quill0224/aoc-final-group13/pics/APR_redSRAM_blueIOPad.PNG

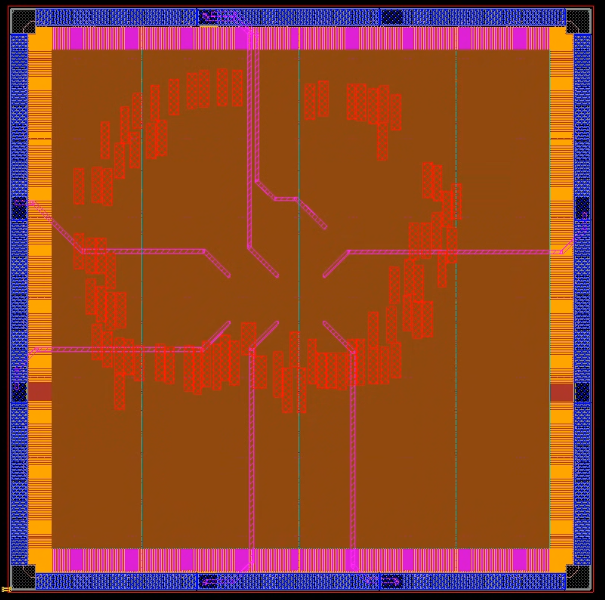
pics/APR_redSRAM_blueIOPad.PNG
