quill0224/aoc-final-group13/pics/APR_delete mark.PNG

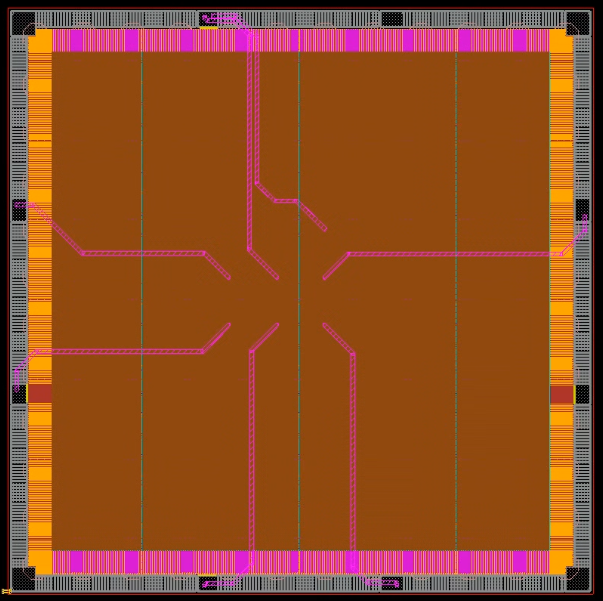
pics/APR_delete mark.PNG
