quill0224/aoc-final-group13/pics/APR.PNG

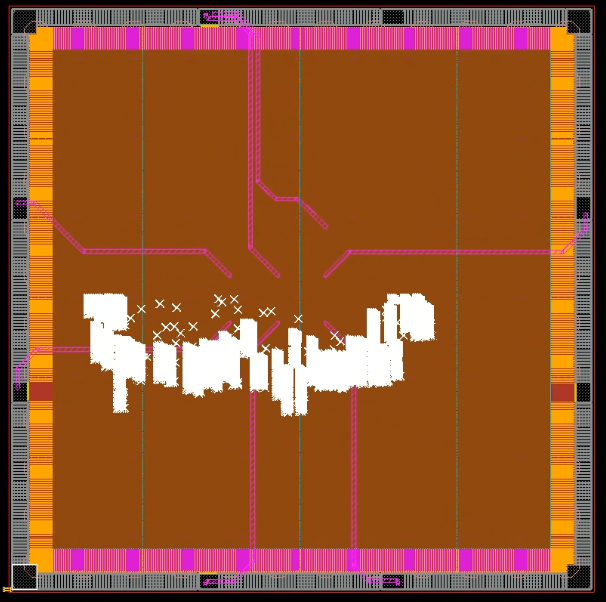
pics/APR.PNG
