quill0224/aoc-final-group13/pics/APR_redSRAM_blueIOPad_yellowclk.PNG

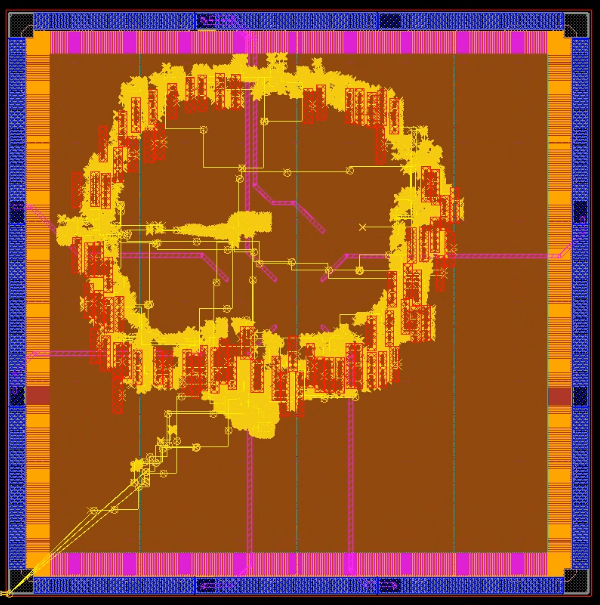
pics/APR_redSRAM_blueIOPad_yellowclk.PNG
