quill0224/aoc-final-group13/pics/clktree.PNG

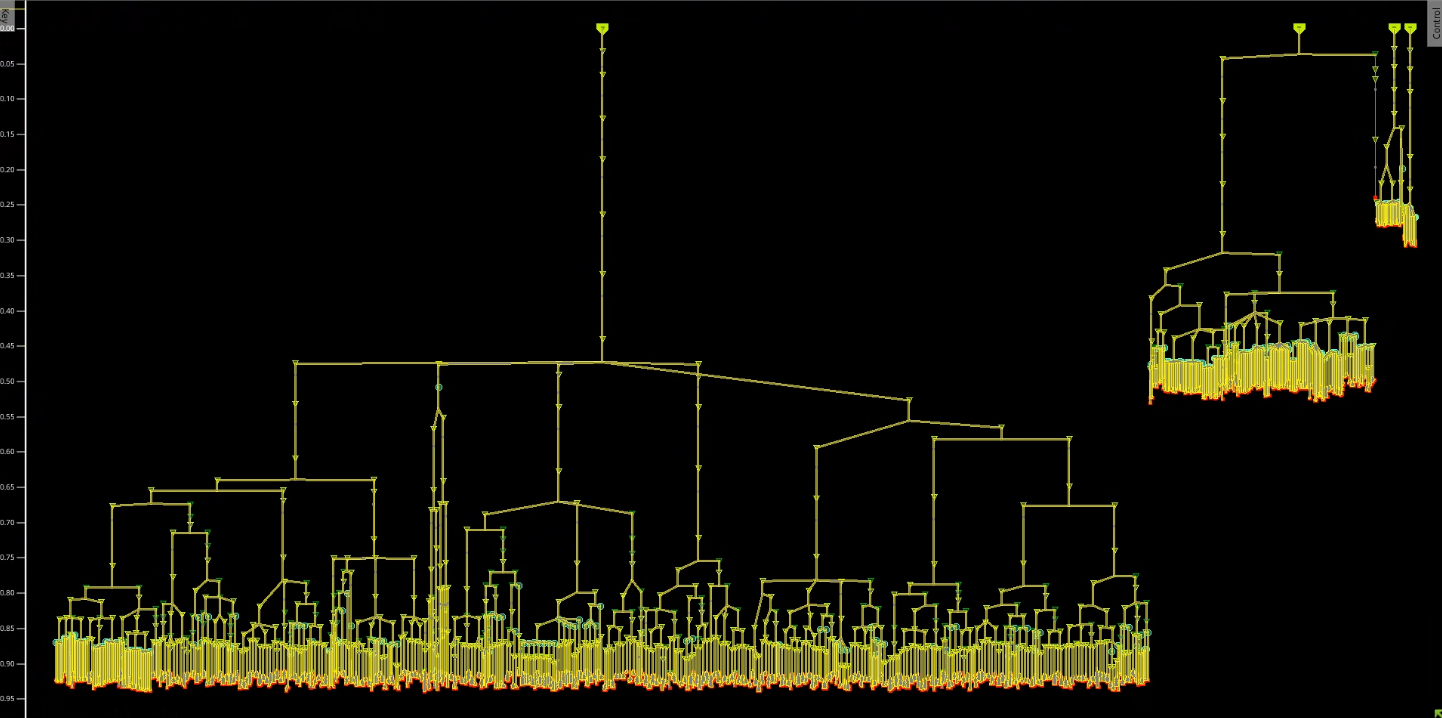
pics/clktree.PNG
