quill0224/aoc-final-group13/pics/soc_architecture.png

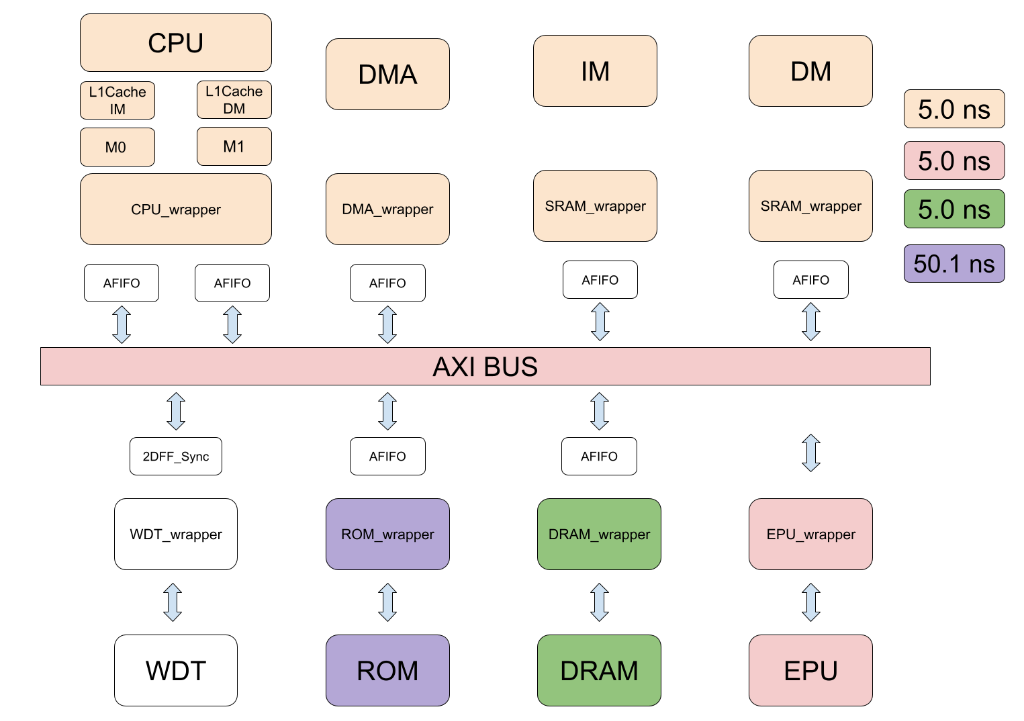
pics/soc_architecture.png
