quill0224/aoc-final-group13/pics/syn0_pass.png

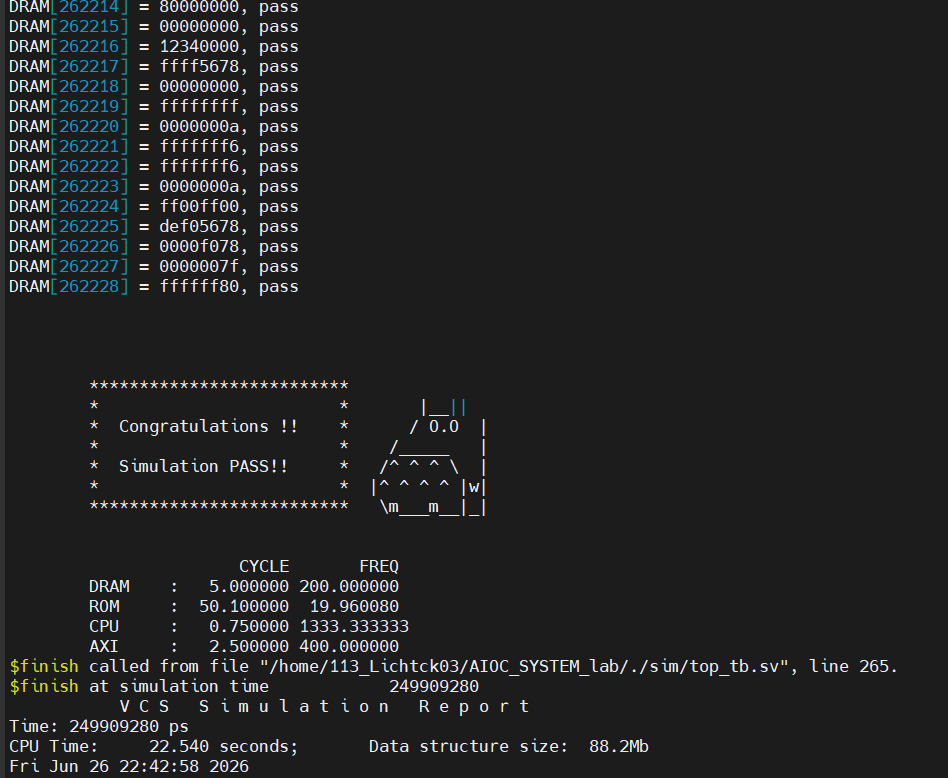
pics/syn0_pass.png
