quill0224/aoc-final-group13/pics/syn2_pass.png

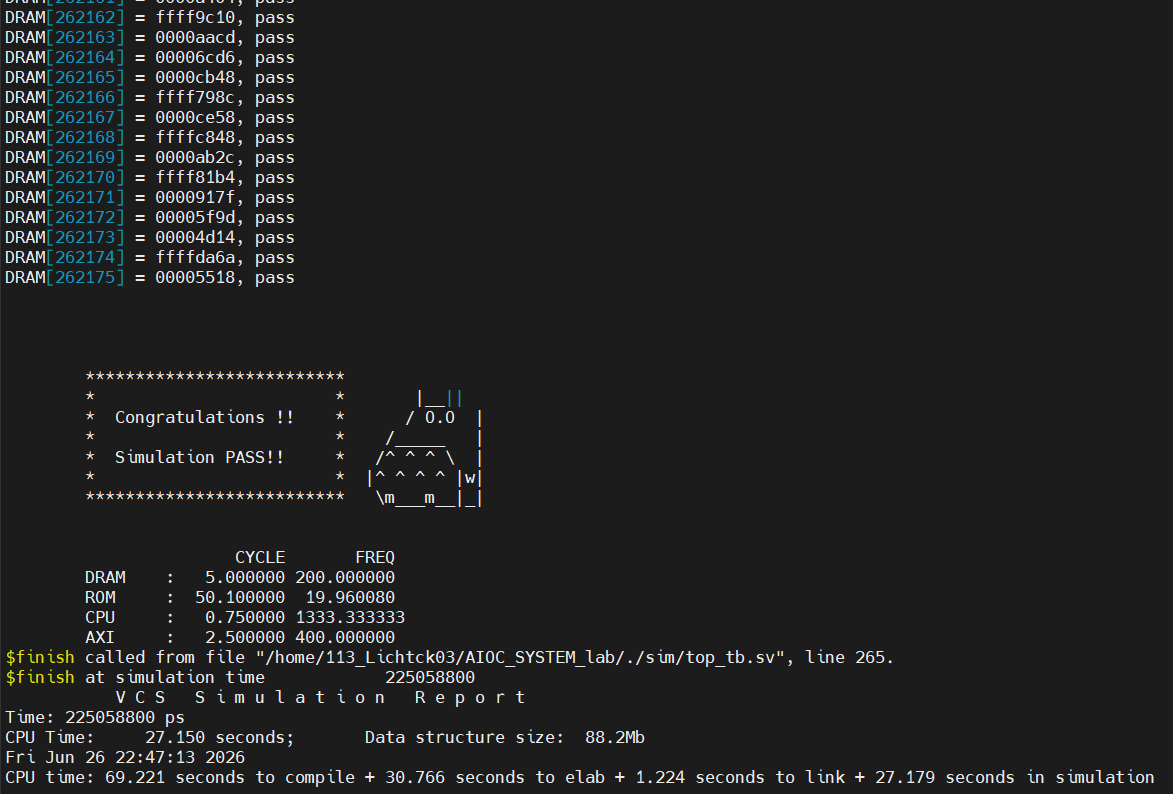
pics/syn2_pass.png
