quill0224/aoc-final-group13/pics/syn3_pass.png

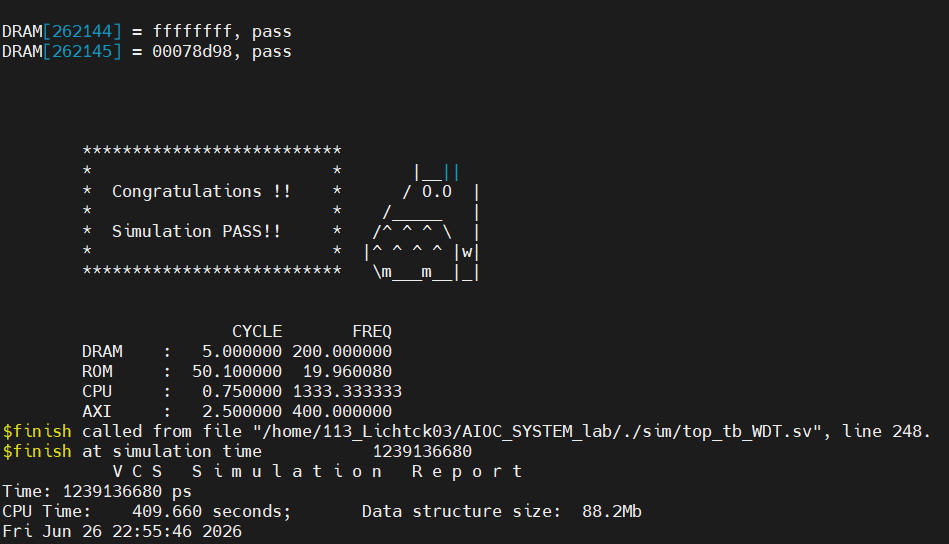
pics/syn3_pass.png
