quill0224/aoc-final-group13/pics/syn4_pass.png

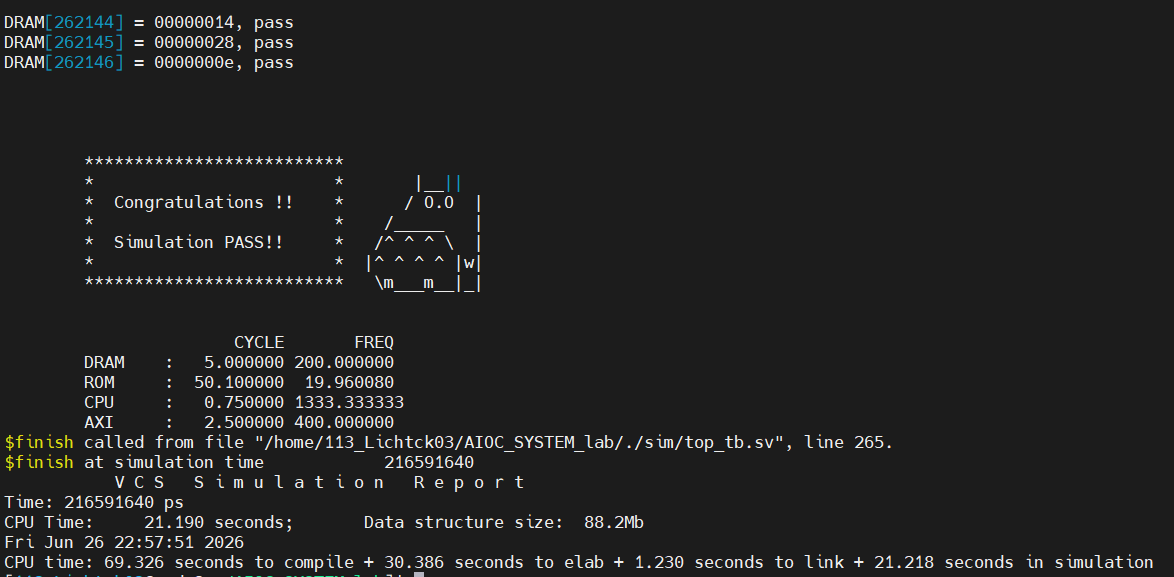
pics/syn4_pass.png
