quill0224/aoc-final-group13/pics/TOP MODULE.drawio.png

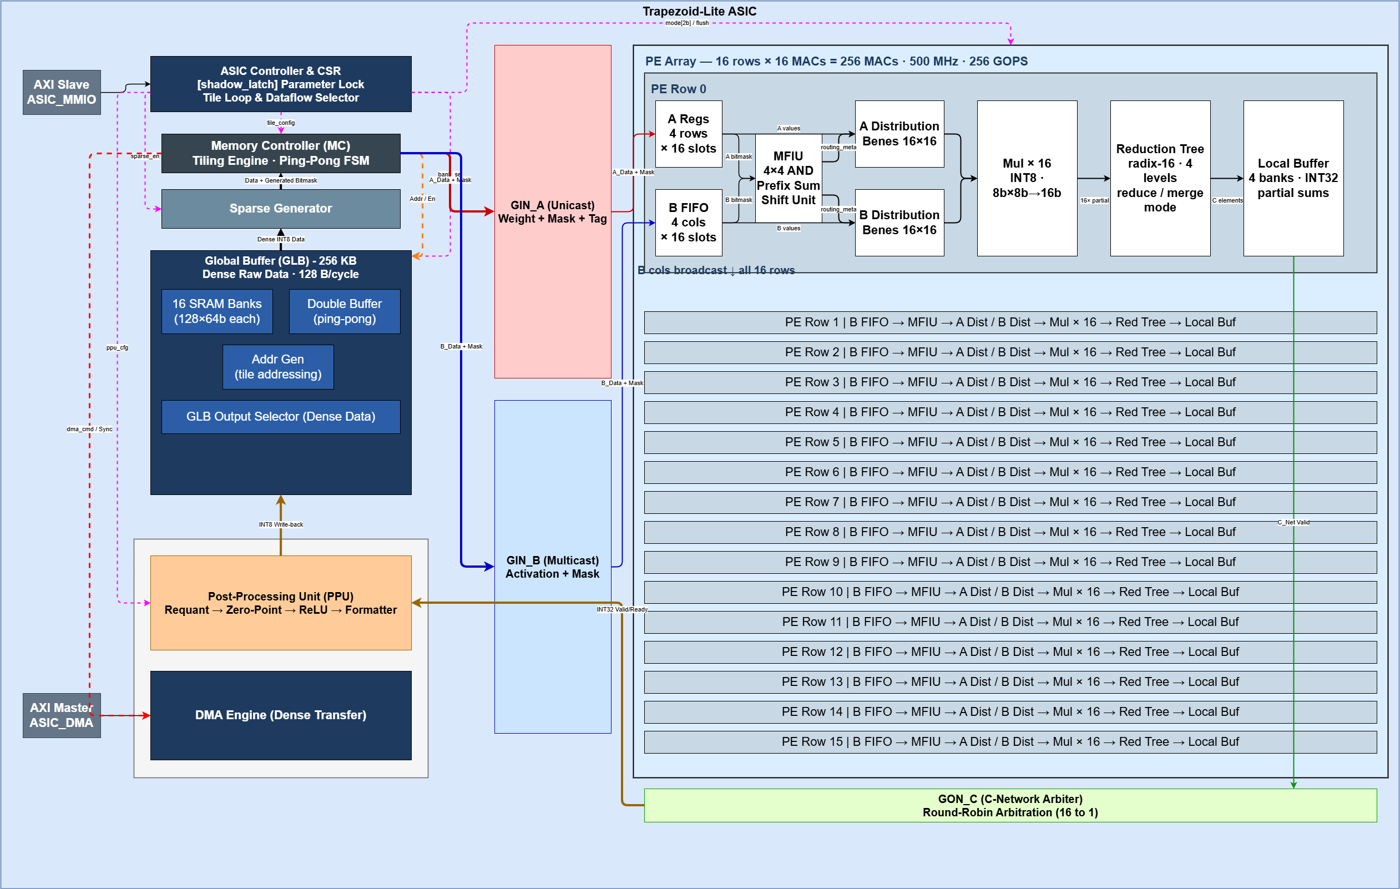
pics/TOP MODULE.drawio.png
