quill0224/aoc-final-group13/AIOC_SYSTEM/APR_new/innovus_stylus/APR/verify/add_dummy/README

To generate dummy and merge, 
first run the 3 script: run_BE.csh run_COD.csh run_FE.csh
then run run_merge.csh at last.
