quill0224/aoc-final-group13/include/runtime/runtime.h

#define RUNTIME_H
#define DEFAULT_m 64
#define DEFAULT_p 4
#define DEFAULT_q 4
#define DEFAULT_r 1
#define DEFAULT_t 2
#define DEFAULT_e 8
#define DLA_INFO_CSV "dla_info.csv"
#ifdef __cplusplus
extern "C" {
#endif
#include <stdint.h>
#include <stdio.h>
void dla_stop();
void create_dla_info_to_csv(const char* filename);
void dump_dla_info_to_csv(const char* filename, const char* operation_name,
                          uint32_t m, uint32_t e, uint32_t p, uint32_t q, uint32_t r, uint32_t t,
                          uint32_t PAD, uint32_t U, uint32_t R, uint32_t S, uint32_t C, uint32_t M, uint32_t W,
                          uint32_t H);
int qconv2d_relu_maxpool(uint8_t* input_in_DRAM, int8_t* filter_in_DRAM, uint8_t* opsum_in_DRAM, int32_t* bias,
                         uint32_t ofmap_len, uint32_t ifmap_len, uint32_t filter_len,
                         uint32_t m, uint32_t e, uint32_t p, uint32_t q, uint32_t r, uint32_t t,
                         uint32_t PAD, uint32_t U, uint32_t R, uint32_t S, uint32_t C, uint32_t M, uint32_t W,
                         uint32_t H, uint32_t scale);
int qconv2d_relu(uint8_t* input_in_DRAM, int8_t* filter_in_DRAM, uint8_t* opsum_in_DRAM, int32_t* bias,
                 uint32_t ofmap_len, uint32_t ifmap_len, uint32_t filter_len,
                 uint32_t m, uint32_t e, uint32_t p, uint32_t q, uint32_t r, uint32_t t,
                 uint32_t PAD, uint32_t U, uint32_t R, uint32_t S, uint32_t C, uint32_t M, uint32_t W, uint32_t H,
                 uint32_t scale);
void qconv2d_relu_maxpool_cpu(uint8_t* input_in_DRAM, int8_t* filter_in_DRAM, uint8_t* opsum_in_DRAM, int32_t* bias,
                             uint32_t ofmap_len, uint32_t ifmap_len, uint32_t filter_len,
                             uint32_t PAD, uint32_t U, uint32_t R, uint32_t S, uint32_t C, uint32_t M, uint32_t W,
                             uint32_t H, uint32_t scale);
void qconv2d_relu_cpu(uint8_t* input_in_DRAM, int8_t* filter_in_DRAM, uint8_t* opsum_in_DRAM, int32_t* bias,
                     uint32_t ofmap_len, uint32_t ifmap_len, uint32_t filter_len,
                     uint32_t PAD, uint32_t U, uint32_t R, uint32_t S, uint32_t C, uint32_t M, uint32_t W, uint32_t H,
                     uint32_t scale);
void qlinear_relu_cpu(uint8_t* input_in_DRAM, int8_t* filter_in_DRAM, uint8_t* opsum_in_DRAM, int32_t* bias,
                     uint32_t ofmap_len, uint32_t ifmap_len, uint32_t filter_len, uint32_t scale);
void qlinear_cpu(uint8_t* input_in_DRAM, int8_t* filter_in_DRAM, uint8_t* opsum_in_DRAM, int32_t* bias,
                uint32_t ofmap_len, uint32_t ifmap_len, uint32_t filter_len, uint32_t scale);
#ifdef __cplusplus
}
#endif
