quill0224/aoc-final-group13/(commit log)

2026-05-07 feat(quantization): port Lab 1 VGG-8 PTQ pipeline as importable modules (#2)
    Lift the single-notebook Lab 1 work into a clean Python package so other
    Final_project modules (analysis/, rtl/) can `import quantization`.
    Modules
    - model.py VGG-8 with QuantStub/DeQuantStub + fuse_model()
    - quantize.py PowerOfTwoObserver + CustomQConfig + ptq_quantization()
    - data.py CIFAR-10 dataloaders (train/val/test split)
    - trainer.py SGD + cosine annealing trainer + evaluate()
    - utils.py save/load + plot helpers
    - run_train.py CLI: train from scratch (~91.7% target)
    - run_ptq.py CLI: PTQ + FP32/INT8 benchmark (target 91.58% / 1.81x / 3.99x)
    Tooling
    - scripts/copy_lab1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
2026-05-07 docs(analysis): commit first baseline sweep run for team reference (#6)
    This is the first canonical sweep output, committed so the team can see
    the proposal-review numbers without each member having to re-run sweeps.
    Future timestamped runs (sweeps_<ts>/) remain gitignored; only this
    'baseline/' directory is whitelisted via .gitignore exception.
    Sweep code commit: PR #5 (fc_analysis overhead fix included).
    Headline numbers (full breakdown in baseline/README.md):
    - PE: 16x16 = 1.56x faster than 6x8 baseline (256 vs 48 PEs)
    - GLB: 64 KiB saves 17% DRAM vs 16 KiB; saturates at 128 KiB
    - FC6 (1 MiB INT8): 103 tiles at 16 KiB GLB; still 2 tiles at 1 MiB GLB
    [fc_analysis.csv, glb_sweep.csv, pe_sweep.csv]
2026-05-07 docs: write proposal v2 patch — ready-to-paste numbers and updated sections (#7)
    Pre-formatted Chinese sections matching v1's chapter numbering, with
    sweep data from PR #6 baseline filled in. Author of v2 PDF can copy
    each section verbatim.
    Sections covered
    - §4.2 PE Array sizing — 5-config sweep + 16x16 = 1.56x baseline + ROI rationale
    - §4.2/§4.4 GLB size — 6-size sweep + 128 KiB saturation point
    - §4-NEW FC layer strategy — FC6 1 MiB needs host fallback, FC7/FC8 on-chip
    - §5.2 Roofline — balance point shift compute->memory bound at PE 16x16 + 4 B/cycle
    - §6.1 NoC — still TODO (RTL phase)
    - §6.4 timeline — adds host-FC integration testing weeks
    Also updates docs/prop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
2026-05-08 test: add Lab 1 + Lab 2 verification suite (#8)
    Add 4 verification scripts under tests/ that prove the Lab 1 quantization
    port and Lab 2 analytical model port match their references. Required
    before proposal v2 — all sweep numbers (PE 1.56x, GLB 128 KiB saturate,
    FC6 1 MiB) are now backed by automated checks.
    Tests:
    - test_power2_observer: PowerOfTwoObserver scale snaps to 2^(-c),
    max_shift clip, dtype to zero_point pairing (14 checks)
    - test_lab2_invariants: macs invariance, GLB capacity, bound_by logic,
    maxpool k^2 shrink across all 5 VGG-8 conv layers (50+ checks)
    - test_lab2_baseline: byte-equal numerical parity vs lab2/src reference
    on every glb_usage / dram_access / glb_access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
2026-05-09 feat(rtl): paper-aligned 16x16 PE array with per-row tree + B forwarding
    - mac_unit: pure INT8 mul, registered output (no per-mul accumulator;
    per-mul acc cannot support TrIP's dynamic mul-to-(a_row, b_col) mapping)
    - pe_row: contains 16 mul + radix-16 merge tree (4-stage pipelined) +
    INT32 row-level accumulator + B-forwarding latch (per Fig 6)
    - pe_array: B columns forward row->row vertically via b_chain[]
    (Fig 7 step 4); cuts B input from 2048b to 128b per cycle
    - merge_tree_radix16 (new): per-row 4-stage pipelined adder tree.
    Replaces incorrect global merge_tree.v (paper has 16 trees, not 1)
    - top.v: drop unused MFIU/dist instances; they will be added per-row
    inside pe_row in Ph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
    [tb_mac_unit.sv, trapezoid_pkg.sv]
2026-05-09 refactor(rtl): clarify merge_tree_radix16 ownership = 施柏安
    Per proposal §6.2, Merge-Reduction Tree module body is owned by 施柏安.
    The previous commit placed merge_tree_radix16.v under rtl/pe/ (黃妍心's
    directory) which crossed ownership boundary.
    - Move rtl/pe/merge_tree_radix16.v -> rtl/dist/merge_tree_radix16.v
    - Add ownership header: 黃妍心 drafted the skeleton so pe_row can lint
    pass; 施柏安 owns the module body and may keep / rewrite / extend it
    (sub-tree slicing for TrIP is his Phase 2 work)
    - pe_row.v: tag the instantiation as 'module body owner = 施柏安'
    - Makefile: update RTL_SRCS path
    - docs/architecture-deltas.md Δ3: clarify owner split
    - docs/yhsin-pe-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
2026-05-12 feat(rtl): SV-style refactor + unit testbenches for mac/tree/pe_row
    Convert all RTL .v -> .sv with Lab 3/4 SV style (logic, always_ff).
    Add tb_tree, tb_pe_row; all unit tests passing in AOC Docker iverilog.
    Architecture decisions (aligned with ISCA 2024 paper Fig 6/7):
    - mac_unit: pure INT8 mul, no per-mul accumulator (TrIP-compatible)
    - pe_row: 16 mul + radix-16 tree + INT32 acc + B-forward latch
    - pe_array: B vertical forwarding (1 B in -> chain down 16 rows)
    - 7-stage pipeline for 500 MHz timing closure margin
    Pending: distribution_net real logic (QuillQ), cache->PE wiring.
2026-05-14 feat(dist): Phase 1 dense identity pass-through + tb (6 cases)
    - rtl/dist/distribution_net.sv: 從全 0 stub 改成 pass-through
    * 加 a_grid_in / b_grid_in input port
    * 用 packed array 整體 assign 做 identity 路由 (256 條獨立 wire)
    * Phase 2 預留 port (dataflow_sel / effectual_idx / effectual_count)
    以註解形式列出，等 MFIU 介面定下來再啟用
    * 純組合 0 cycle latency，吃 mul stage 的 setup time
    - sim/tb_distribution_net.sv: 6 個 test cases
    * T1 全 0 / T2 全 +1 / T3 全 -1 / T4 linear / T5 INT8 邊界 / T6 random
    * 用 row temp 兩階段 assign 繞 iverilog 2D-packed 雙變數 index 限制
    * header 註解記錄 iverilog 跟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
2026-05-15 fix(dist): align B port with pe_array b_vec_top (single row)
    Phase 1 dist net B 路徑原本輸出 full grid [16][16][8]，但 pe_array
    因為 B-chain forwarding 只吃 single row [16][8] (對齊 paper Fig 7
    step ④ + interfaces.md §1)。改成對齊介面契約後 top.sv 可以直接接。
    - rtl/dist/distribution_net.sv:
    * input b_grid_in [16][16][8] → b_vec_in_top [16][8]
    * output pe_b_grid [16][16][8] → pe_b_top [16][8]
    * 註解補上 B 為何 single row (chain forwarding + 省 16x bw)
    - sim/tb_distribution_net.sv:
    * 配合新 port 改 DUT 訊號 / set_all_uniform / check_pass_through
    * B 路徑改用 1D 單變數 index loop (不用 row temp)
    * T4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
2026-05-15 feat(rtl): add merge_tree_radix16_sliced for TrIP MS×MS sub-tree slicing
    Implements paper §III.B Fig 10 — 16-input reduction tree that can be
    sliced into multiple contiguous sub-trees, each producing one C element.
    Needed for TrIP MS×MS (single-tree mode emits only 1 C/cycle).
    Algorithm: Kogge-Stone parallel prefix sum with selective reset.
    4-stage pipeline — same latency as merge_tree_radix16, so pe_row stays
    at 7 stages once integrated.
    Backward compatible: cut_after=0 falls back to single 16→1 sum, so
    Dense IP and MS×D dataflows can use this module without code change.
    Bit-width: all stages internally INT32 (avoids iverilog packed-array
    variable-index bit-select limitation; s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
    [tb_merge_tree_sliced.sv]
2026-05-15 docs(tb): fix sliced-tree case description
    Agent-Logs-Url: https://github.com/quill0224/aoc-final-group13/sessions/9cd9bb58-eb38-4c86-8c49-e632954f98c0
    [tb_merge_tree_sliced.sv]
2026-05-18 feat(tb): add tb_pe_array (Dense IP + B chain, 49 sub-checks)
    - tb_pe_array.sv: 49 sub-checks across T1-T4
    - T1: reset state (1 check)
    - T2: K=1 uniform a=1·b=1 → all rows c_out=16 (16 checks)
    - T3: K=1 per-row A → row r c_out=(r+1)*16 (16 checks)
    - T4: K=2 accumulation → all rows c_out=80 (16 checks)
    All pass under iverilog -g2012 in AOC Docker.
    - Makefile: tb_pe_array target now builds real (was TODO placeholder)
    [tb_pe_array.sv]
2026-05-22 fix(tb): correct owner annotation (QuillQ = 王柏弘, not 施柏安)
2026-05-25 feat: 新增 CPU、AXI 等系統與架構模組 RTL
2026-05-25 test: 新增 CPU 與系統模組 testbench
2026-05-25 chore: 新增 Makefile、腳本與系統架構圖
2026-05-26 docs(pe_row): add timing-rule warning around c_out conditional dump
    The `(acc_dump && tree_valid)` fallback only works if dataflow_ctrl
    aligns acc_dump exactly to "last in_valid + 6 cycles". A 1-cycle skew
    either way corrupts the dot-product result. Spell out the failure
    modes and suggest two safer FSM strategies for Phase 2 (TrIP per-row
    control), so the next person touching this knows what timing contract
    they must hold.
    No behavioural change.
    [pe_row.sv]
2026-06-04 feat(buffer): wire real N16ADFP SRAM macro into wrapper + synth.tcl macro mode
2026-06-04 docs: add §9 — general 'find & use a macro' workflow (reusable for other macros/courses)
2026-06-04 docs: NPU↔AIOC SoC integration notes (2-layer arch, AXI slave S6, open questions)
2026-06-05 feat(pe): pe_row_full integration + final-quality synth flow + interface contract
2026-06-11 docs(rtl): rewrite module headers as function-focused specs + add RTL walkthrough
    - 統一五檔檔頭:功能/資料路徑位置/介面/時序(/假設/組態)
    - 移除 owner、歷史演變敘述;上下游只寫角色不寫實作
    - docs: PE row RTL 程式碼導讀(語法+結構)
2026-06-11 chore(rtl): remove superseded modules, retire legacy Makefile targets
    刪除被最終 stack 取代的舊檔:
    - pe_row / pe_array(→ pe_row_full)
    - merge_tree_radix16 / _sliced(→ _flexagon)
    - distribution_net(→ dist_net_row)、mfiu_top(→ mfiu_row)
    - top / global_buffer / dataflow_ctrl(舊骨架,依 NPU wrapper 分工重寫)
    - 對應 5 個舊 testbench
    Makefile:RTL_SRCS 改最終 8 檔、lint top → pe_row_full、
    退役 tb_tree/tb_tree_sliced/tb_pe_row/tb_pe_array/tb_dist。
    驗證:6 個 tb 全 PASS + lint clean。
2026-06-16 feat(pe): 16x16 pe_array (B vertical chain) + mfiu_trip TrIP shim + tbs
2026-06-16 feat(dist): add TrIP multi-fiber 2D-gather distribution module
    - rtl/dist/dist_net_row_trip.sv: TrIP 多 fiber 分配網路整合版
    * 演算法移植自楊承豫 FPGA MVP 的 trip_distribution_network.v
    * 改成 SystemVerilog + import trapezoid_pkg (型別 single source)
    * scale 到 spec: N_A_FIBER=4 / N_B_FIBER=4 / BITMASK_W=16 / LANES=16
    * 2D gather: a_lane[l]=a_values[row_sel][k_sel], b 同理用 col_sel
    * 補 DIST_STAGES=1 output register + in_valid->out_valid handshake
    * 攤成 unpacked flat array 繞過 iverilog packed-array 變數 index 限制
    * 檔頭附「楊 flat bus -> 本檔多維 port」對照表給 pe_row wrap 接線用
    * Dense 版 dist_net_row.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
2026-06-16 refactor(mfiu): wire mfiu.v into datapath as mfiu_adapter intersection core
    - mfiu_adapter (renamed from mfiu_row) wraps mfiu.v as the intersection
    engine (1 fiber pair, K=16); Dense (all-ones->identity) + TrIP
    (sparse->compaction) share one core
    - drop redundant mfiu_trip.sv + tb (superseded by mfiu_adapter)
    - Makefile / synth.tcl: add mfiu.v dependency; rename targets/paths
    - docs: mfiu_row -> mfiu_adapter
2026-06-16 Fix MFIU intersection buffer read alignment
    [tb_trip_intersection_top.v, trip_intersection_top.v]
2026-06-17 Add sampled VGG conv1_1 GEMM testbench
2026-06-17 test(dist): add multi-fiber packing demo + single→multi switch guide
    - sim/tb_dist_net_row_trip.sv: 加 Scenario 2 多 fiber packing 實證
    * 4 個輸出 (0,0)(0,1)(1,0)(1,1) 共 16 個有效運算塞滿 16 lane
    * 每 lane 各自 (row,col,k) 不同,驗證 2D gather + 100% 利用率
    * 連同原 Scenario 1 (gather/廣播/invalid/registered) 全過
    - docs/multi-fiber-switch-guide.md: 單 fiber → 多 fiber 切換指南
    * 列出要改的檔(依負責人):distribution(我,ready)、MFIU adapter
    (4×4 + 吐三條 sel)、pe_row_full(換 module + port 對照表)、2D 餵料
    * 結論:distribution 不是瓶頸,缺口在上游 MFIU/adapter + 2D 餵料
    兩條線並行:單 f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
2026-06-17 feat(mfiu): add multi-fiber MFIU adapter + end-to-end chain test
    - rtl/mfiu/mfiu_adapter_mf.sv: 多 fiber 版 MFIU adapter
    * instantiate 楊 mfiu.v 核心,設 4×4 (N_A_FIBER × N_B_FIBER)
    * 吐三條 a_row_sel/b_col_sel/k_sel + lane_valid (flat→多維)
    * 補 MFIU_STAGES pipeline,直接接 dist_net_row_trip
    * 跟 Iris 單 fiber 版 mfiu_adapter.sv 並存(整合時選用)
    - sim/tb_mfiu_mf_chain.sv: 端到端串接測試 (make tb_mfiu_mf_chain)
    * bitmask → mfiu_adapter_mf 交集 → dist_net_row_trip 2D gather
    * 2 個有效運算落在不同輸出 (0,0,k3)/(2,1,k5),驗證值正確
    * 結果 ALL PASS (match_count=2, 值對)
    - docs/multi-fiber-switch-guide.md: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
2026-06-17 feat/colin:refine analysis
    [fc_analysis.csv, glb_sweep.csv, pe_sweep.csv]
2026-06-21 Connect MC packet stream to PE via new pe_entry (A/B two-phase ingress)
    - MC.sv: per dispatch send A-tile then B-tile (two-phase, single GLB read
    port reused; B-phase points pkt_base at GLB_B). A/B tag carried in
    Word0[31] = pe_cfg_length[15]; word count uses length[4:0].
    - pe_entry.sv (new): consume MC pe_cfg/pe_data, assemble one compressed
    fiber, route to A/B by tag, emit per-fiber
    out_{bitmask,nz,len,side,idx,valid}.
    - integration.sv: un-mock - insert pe_entry between MC and the obs taps;
    MC pe_cfg/pe_data ready now driven by pe_entry (mock_*_ready retired).
    - data_packer.h / main.c: add is_b param to compress_to_hex; B packets
    set Word0[31].
    - tb/testbench/dla/Makefile: add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
2026-06-21 Fix case_INTEGRATION trace for A/B two-phase ingress
    - workload.c: one MC dispatch is now A-tile + B-tile = 2*CMD_PKT packets.
    Advance N every 2*CMD_PKT; latch both the A-phase first packet
    (packet_in_tile==0) and B-phase first packet (==CMD_PKT); label A/B
    from the header is_b (pe_cfg_length[15]); mask length[4:0]; double the
    expected-packet count; flush prints cur_m-1 (cur_m already advanced).
    - tb.h / tb.cpp: intg_get_pe_cfg_length now returns uint16_t. It was
    uint8_t, which truncated the 16-bit field and dropped the is_b tag at
    bit15 (so B packets were mislabeled as IFMAP A).
    Trace now labels IFMAP A / Filter B correctly; 256/256 packets, M=0/1.
    [workload.c]
2026-06-21 Add crossbar: TrIP value gather (mfiu meta -> compressed A/B values)
    - rtl/pe/crossbar.sv (new): resolves each lane's mfiu meta into the actual
    values held in pe_ab_buffer.
    a_val[l] = a_nz_row[ a_meta[l] ]
    b_col = grp_base + b_meta[l][5:4]
    b_val[l] = b_nz[ b_col ][ b_meta[l][3:0] ]
    lane_col + lane_valid per lane; invalid lanes (l >= effectual) -> 0.
    Per PE row: A uses its own fiber (a_nz_row = buffer.a_nz[r]); B (b_nz) is
    shared across rows. Flattens the packed buffer arrays internally for the
    variable-index gather. Pure combinational (downstream mac registers).
    Interface matches pe_mfiu_seq + pe_ab_buffer only.
    - sim/tb_crossbar.sv (new): iverilog TB — group0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
    [tb_crossbar.sv]
2026-06-21 Wire pe_array into integration (MC->pe_array) + retire pe_row_full
    - rtl/pe/pe_array.sv: new lite array = pe_entry + pe_ab_buffer + 16x pe_row
    (B broadcast; start=tile_ready; pe_compute_done = AND(16 row done)+drain);
    expose dbg_ent_* observation taps for the integration DEBUG trace.
    - rtl/pe/pe_row.sv: thin per-row chain pe_mfiu_seq -> crossbar -> pe_row_tail.
    - src/integration.sv: swap bare pe_entry -> pe_array. MC egress wiring,
    obs_pe_* taps and the pe_out_* DEBUG trace preserved byte-identical;
    wire controller global_mode/pe_first_pass/pe_cur_n_base to the array.
    - tb/testbench/dla/Makefile: case_INTEGRATION filelist adds the PE subsystem
    + mfiu (trapezoid_pkg, mfiu, mac_unit,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
    [integration.sv, pe_array.sv, pe_row.sv]
2026-06-22 Add tb_pe_row: standalone TB for the per-row compute chain
    Verifies pe_mfiu_seq -> crossbar -> pe_row_tail end-to-end (the
    mfiu + crossbar path that tb_pe_row_tail skipped by feeding synthetic
    crossbar outputs). Feeds buffer-style bitmask/nz, computes the golden
    in-TB, drives dump, compares c_out per column.
    Covers: multi-column intersect, no-intersect column (not written),
    signed int8 weights, 2-K-tile accumulate, cur_n_base offset,
    first_pass overwrite, second B-group. PASS on verilator
    (addr 0/1/2/8/16 = 90/20/20/60/4).
    Also: drop emoji from pe_array.sv comments.
    [pe_array.sv, tb_pe_row.sv]
2026-06-22 Integration psum dump + per-tile handshake + clear-on-dump
    End-to-end MC->pe_array now dumps real psum and is internally
    consistent across M-tiles (no cross-tile residue).
    - controller.sv: add pe_tile_done input + S6B_WAIT_PE state. The
    controller now waits for the PE to finish each tile before dispatching
    the next, fixing the back-to-back tile race (lost mfiu_seq starts /
    pe_ab_buffer overwritten mid-compute).
    - pe_array.sv: emit pe_tile_done (per-tile compute-done pulse: armed on
    start, fires on pe_compute_done rising edge); expose dbg_ent_*
    (internal pe_entry fiber observation) + obs c_out/c_valid/compute_done.
    - local_buffer_row.sv: dump is now read-and-CLEAR (clear the dumped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
    [controller.sv, integration.sv, local_buffer_row.sv, pe_array.sv, tb_pe_row_tail.sv, workload.c]
2026-06-22 Add EPU_wrapper: PE engine as AXI-S6 slave + SoC integration
    - rtl/EPU_wrapper.sv: AXI4 slave (S6 @ 0x0005_0000), single-beat, axi_clk
    domain. MMIO register file feeds pe_array (cfg/data push, mode/first_pass/
    cur_n_base/dump) and latches dumped C columns (RESULT0..15) for CPU
    readback. dump_en gated by pe_compute_done; result_valid auto-clears on
    DUMP; side-effect pulses gated on WLAST (burst-safe).
    - top.sv: replace the S6 tie-off stub with the EPU_wrapper instance
    (axi_clk / ~axi_rst).
    - AXI.sv: add the M1_S6_r branch to the M1 read mux (the M1->S6 write path
    was already pre-wired) so the CPU can read EPU status/results.
    - rtl_sim.f: add the PE engine + EPU_wrapper to the sim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
    [AXI.sv, EPU_wrapper.sv, top.sv]
2026-06-24 docs(rtl): clean up and correct module comments
    [local_buffer_row.sv, mac_unit.sv, mfiu.sv, pe_ab_buffer.sv, pe_array.sv, pe_entry.sv, pe_mfiu_seq.sv, pe_row.sv]
2026-06-26 Add MFIU area optimizations: gather-in-MFIU, BUCKET_REDUCE, crossbar cleanup
    - mfiu.sv: sequential lane gather in FILL_COL (replaces 16x parallel mux)
    - pe_mfiu_seq.sv: remove 16-lane comb gather block
    - pe_row_tail.sv: 4-bucket accumulator (BUCKET_REDUCE)
    - crossbar.sv: simplify routing logic
    - pe_ab_buffer/pe_array/pe_row: interface wiring updates
    - sram_128x32_1r1w.sv: add USE_SRAM_BLACKBOX support
    Area result: 885,568 -> 625,902 cells (-29.3%)
    [mfiu.sv, pe_ab_buffer.sv, pe_array.sv, pe_mfiu_seq.sv, pe_row.sv, pe_row_tail.sv, sram_128x32_1r1w.sv]
2026-06-26 Revert "Add MFIU area optimizations: gather-in-MFIU, BUCKET_REDUCE, crossbar cleanup"
    This reverts commit 8ec09c97dd4dc16dc38b2b886c4d8cd5ee016a72.
    [mfiu.sv, pe_ab_buffer.sv, pe_array.sv, pe_mfiu_seq.sv, pe_row.sv, pe_row_tail.sv, sram_128x32_1r1w.sv]
